ZhiliangMa/202004-F103-IOT-DEV_V1/(threads)

Thread 1 (2020-10-10):

作者你好，我下载了你分享的这个程序。内容完全不是你所说的呀。除了 OLED ，UART1 外都不能运行呀！

OPYS2, 2020-10-10:
你好 ，为了验证我买的W5500模块是否正常，下载了这个程序 。发现除了 SPI1 端口接的 OLED屏，和 UART1 串口可以运行外 ，UART2 UART3  SPI2（W5500）根本无法运行，你的程序都不全呀。不全你也不标示一下 ，有需要的人 下来使用 ，又要浪费多少时间，排查 ，除错。特别是STM32的 程序都是交叉库的形式调用，组合在一起的 。而且是生手，不知道你的编写思路，流程的人，是真的痛苦。
如果你是达成这个功能目标，请在说明文档内，说一下，哪些不完整 需要完善 ，那些有缺陷 需要修正。相互学习提升能力，才是目的。
  谢谢你的 分享。

ZhiliangMa, 2020-10-10:
W5500确实没有完善程序，博客里面有说。硬件是支持的。由于时间有限，主要还是用的ESP8266。W5500的程序估计不会更新了，应用太局限了，不想花太多时间在这单一硬件上面。如果有需要，你可以找找超纬电子的资料，esp8266联网部分我是参照他的，W5500实在没空抱歉，可以参照他的进行开发。

------------------&nbsp;原始邮件&nbsp;------------------
发件人:                                                                                                                        "ZhiliangMa/202004-F103-IOT-DEV_V1"                                                                                    <notifications@github.com&gt;;
发送时间:&nbsp;2020年10月10日(星期六) 中午12:53
收件人:&nbsp;"ZhiliangMa/202004-F103-IOT-DEV_V1"<202004-F103-IOT-DEV_V1@noreply.github.com&gt;;
抄送:&nbsp;"Subscribed"<subscribed@noreply.github.com&gt;;
主题:&nbsp;[ZhiliangMa/202004-F103-IOT-DEV_V1] 作者你好，我下载了你分享的这个程序。内容完全不是你所说的呀。除了 OLED ，UART1 外都不能运行呀！ (#1)

你好 ，为了验证我买的W5500模块是否正常，下载了这个程序 。发现除了 SPI1 端口接的 OLED屏，和 UART1 串口可以运行外 ，UART2 UART3  SPI2（W5500）根本无法运行，你的程序都不全呀。不全你也不标示一下 ，有需要的人 下来使用 ，又要浪费多少时间，排查 ，除错。特别是STM32的 程序都是交叉库的形式调用，组合在一起的 。而且是生手，不知道你的编写思路，流程的人，是真的痛苦。
 如果你是达成这个功能目标，请在说明文档内，说一下，哪些不完整 需要完善 ，那些有缺陷 需要修正。相互学习提升能力，才是目的。
 谢谢你的 分享。

—
You are receiving this because you are subscribed to this thread.
Reply to this email directly, view it on GitHub, or unsubscribe.
