ZhiliangMa/202004-F103-IOT-DEV_V1/F103-IOT-IC.pdf

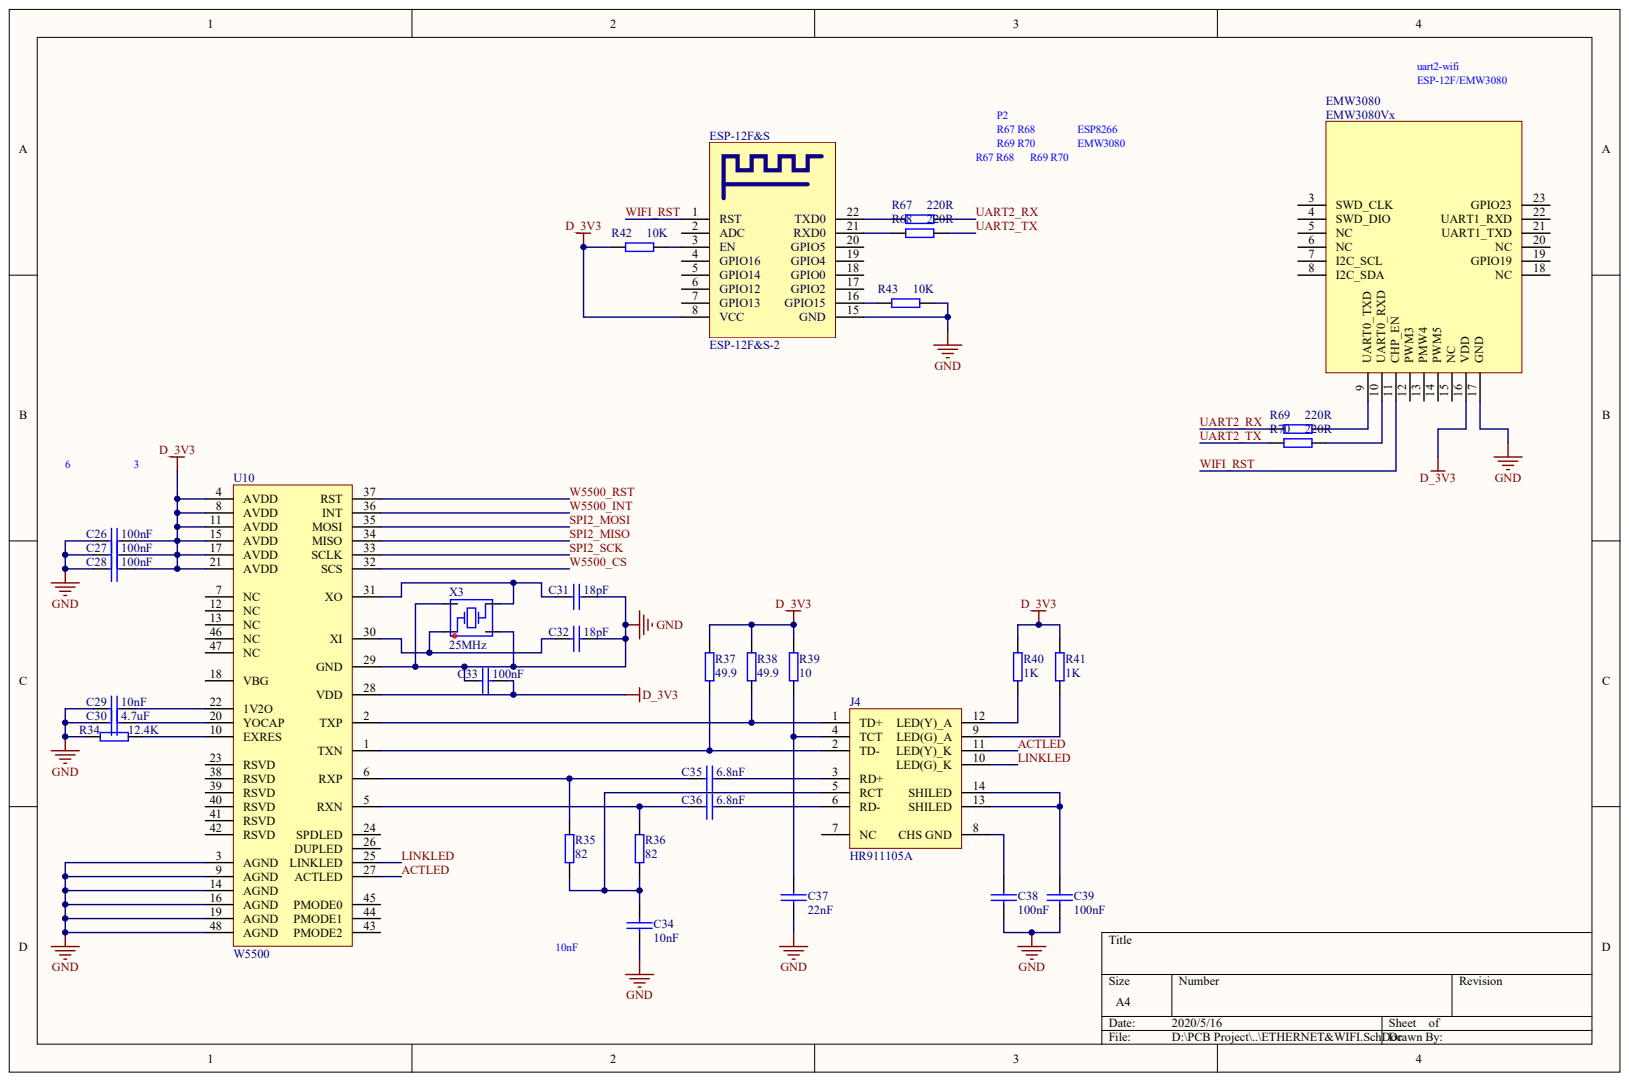
[picture p3: page 1]

C27 | 100nF | AVDD 17
C28 | 100nF | AVDD 21

EXRES 10 | TCT 4

AGND 9
AGND 14
AGND 16
AGND 19
AGND 48

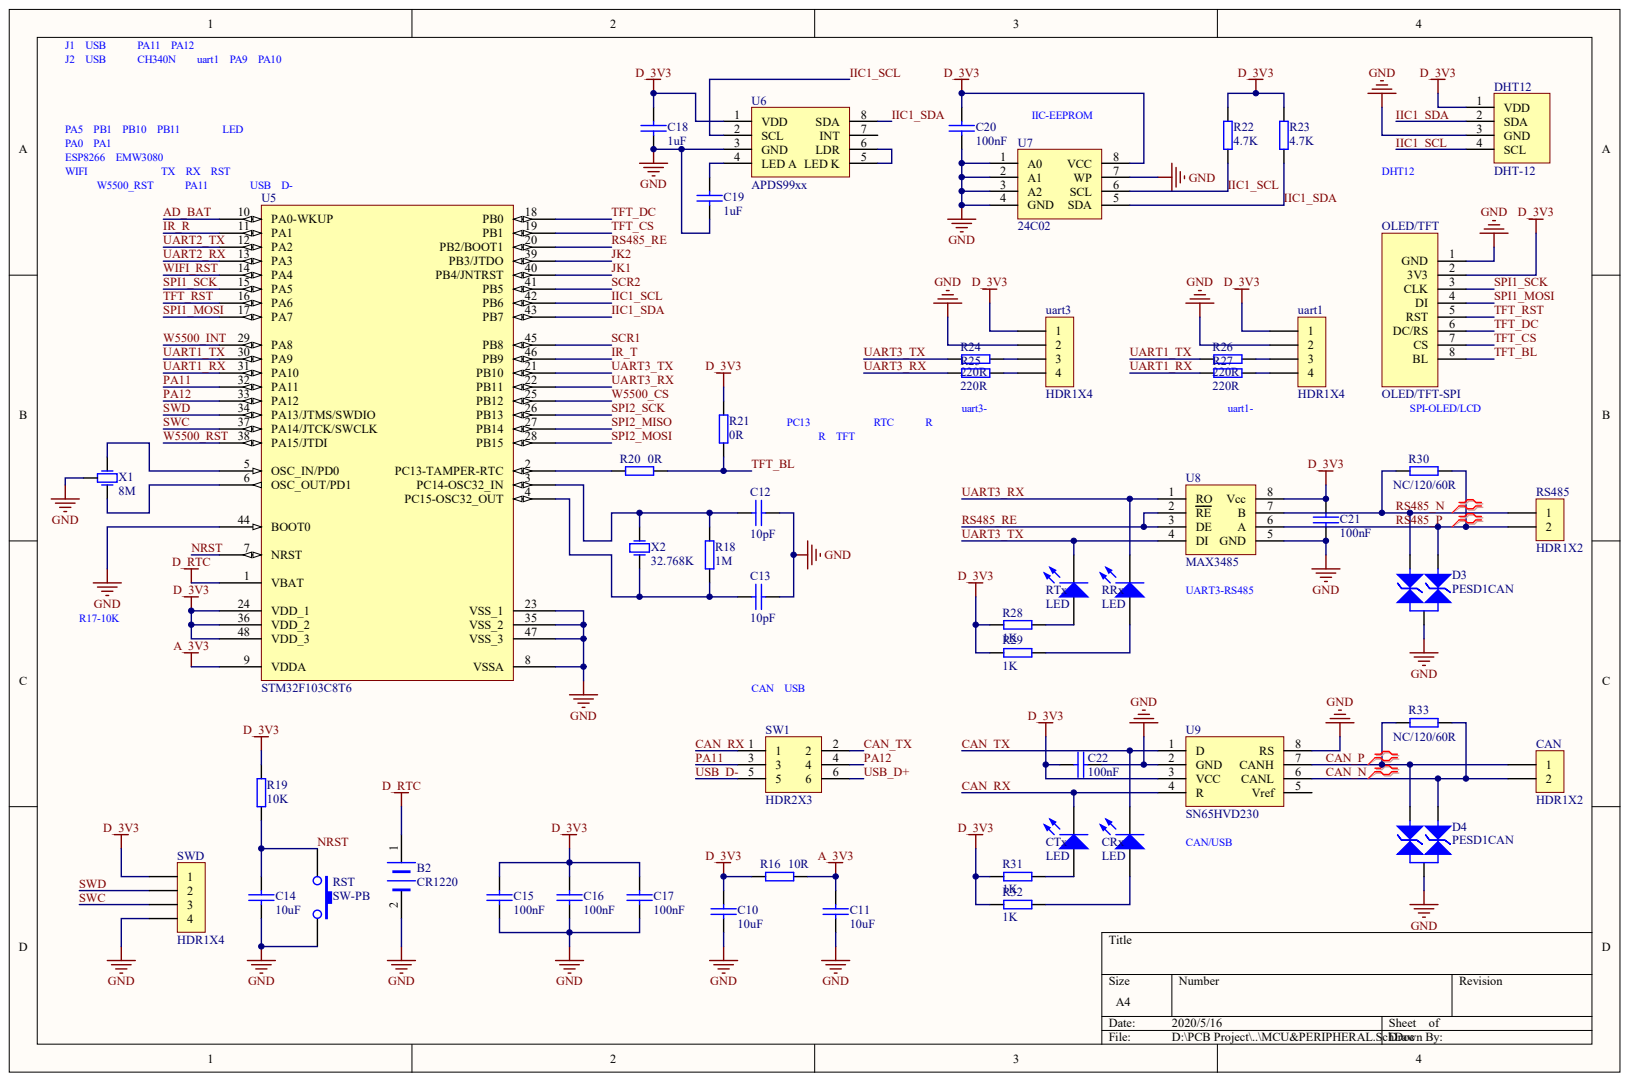
[picture p4: page 2]

X1 | OSC_OUT/PD1 6

OSC_IN/PD0 5

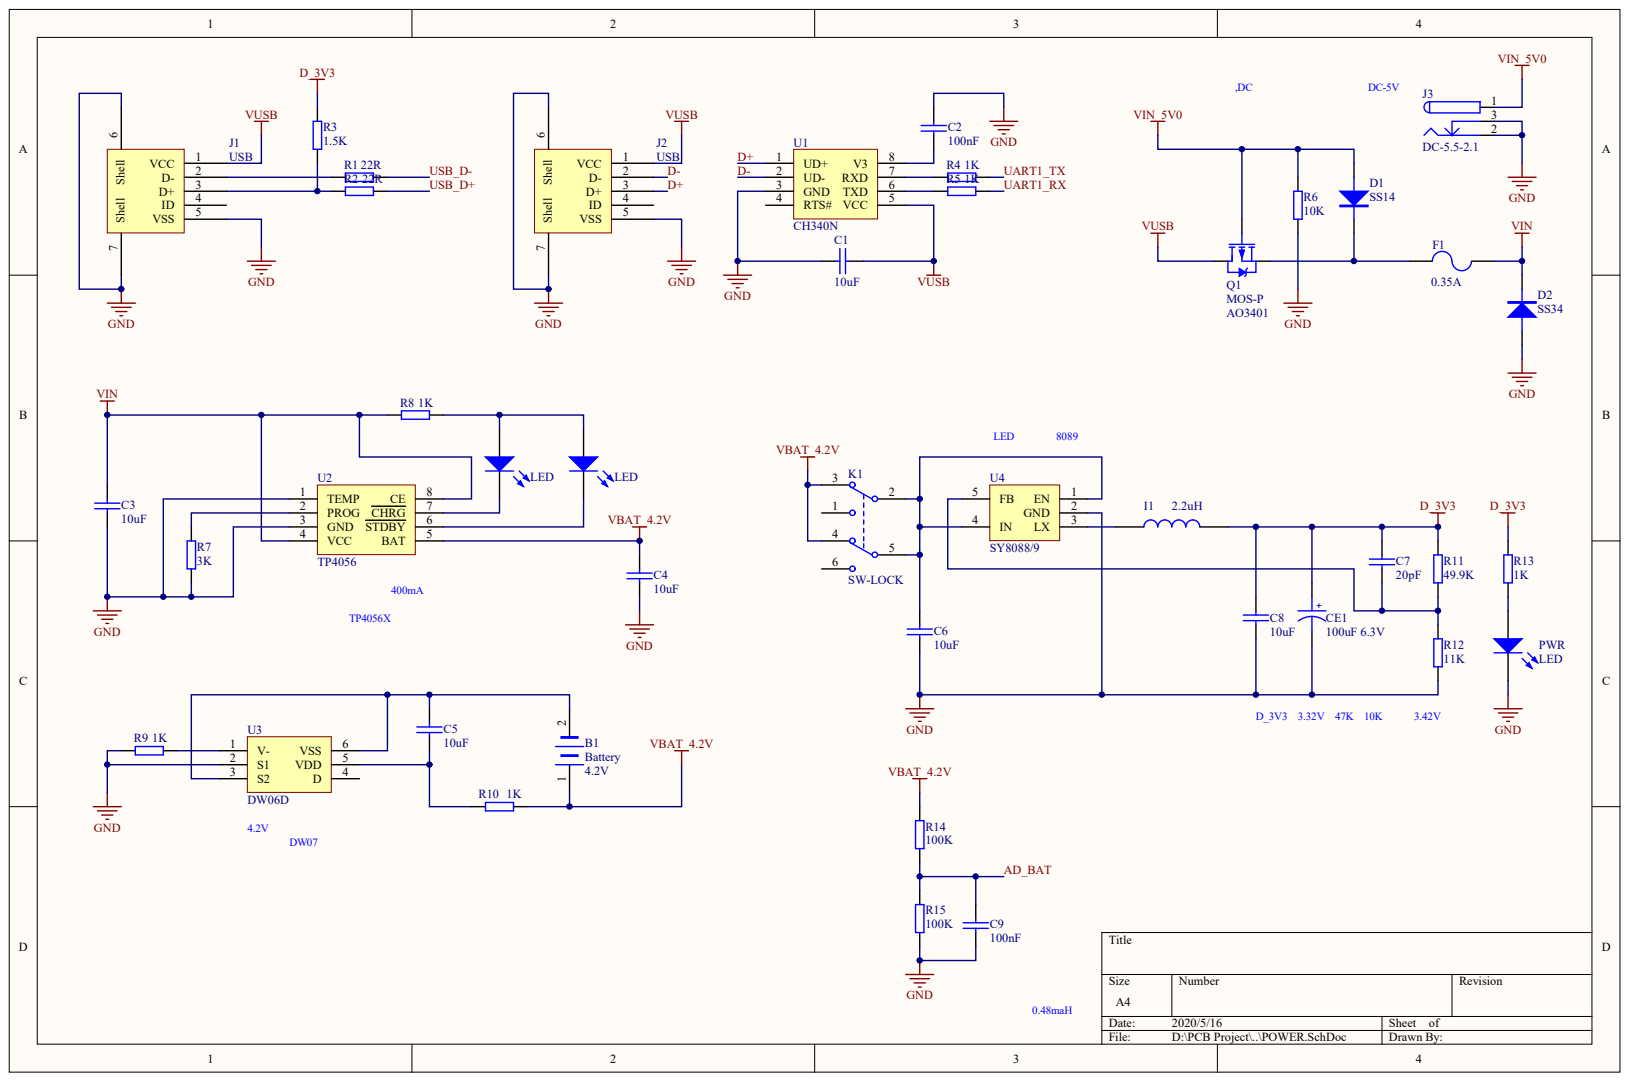
[picture p5: page 3]

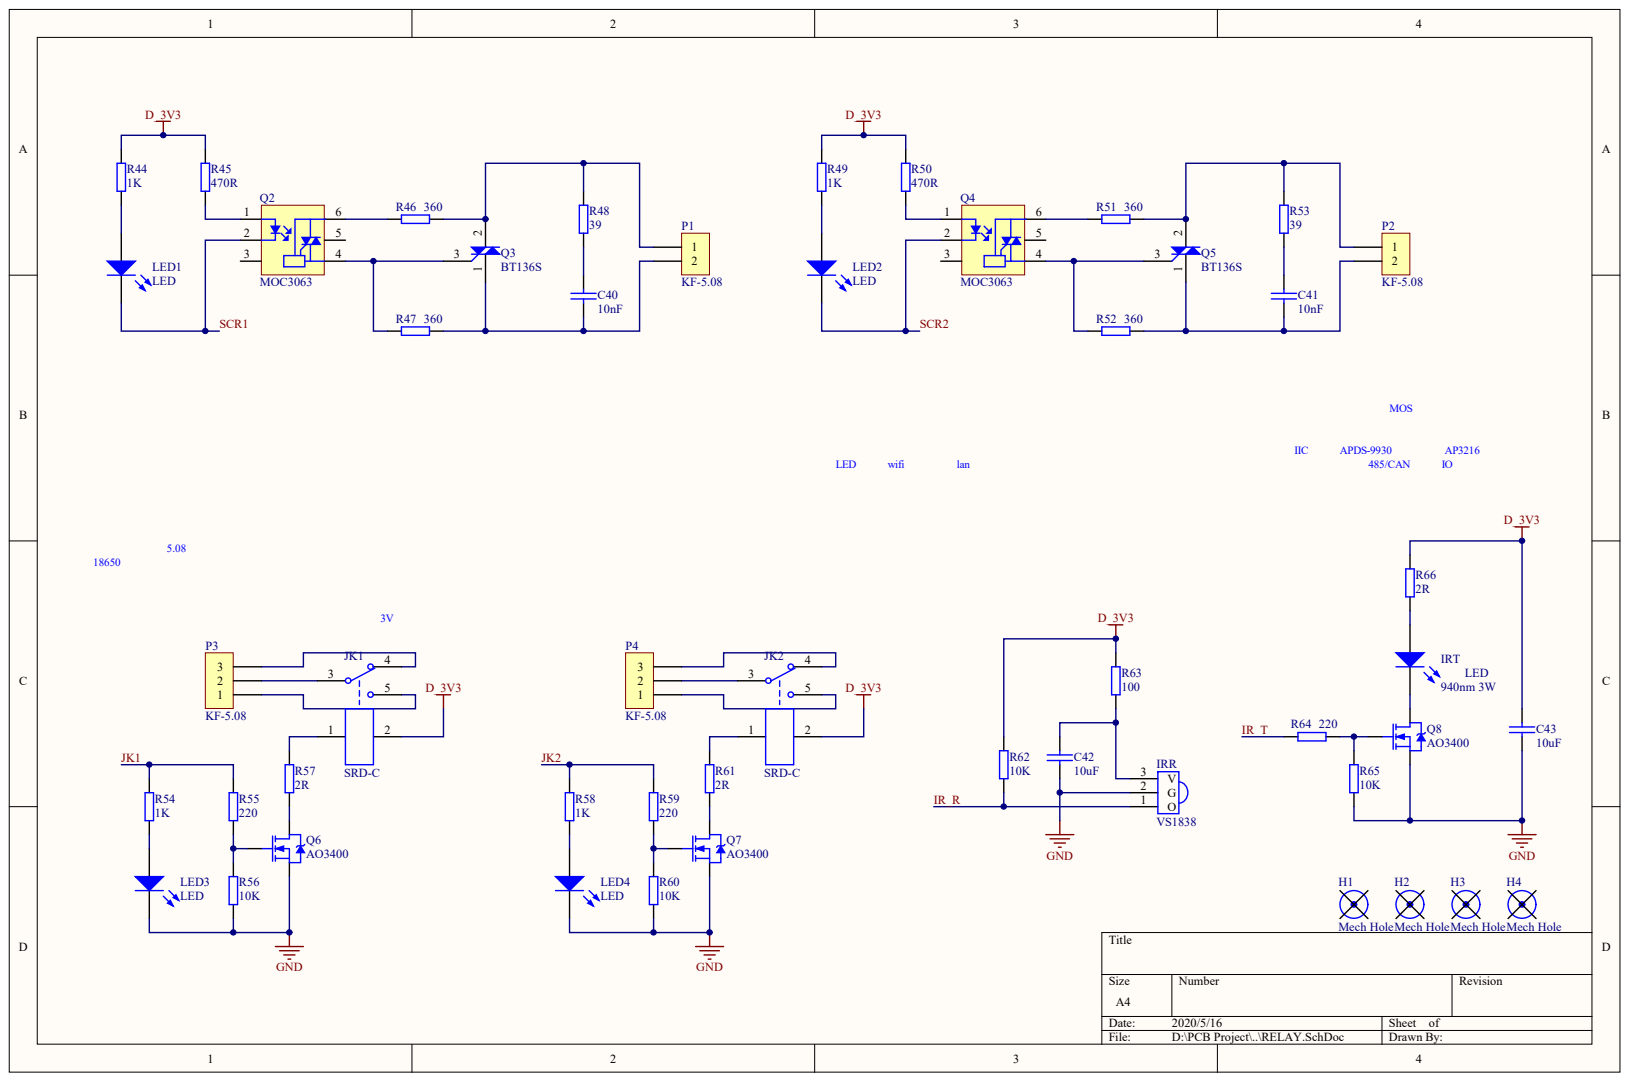
[picture p6: page 4]

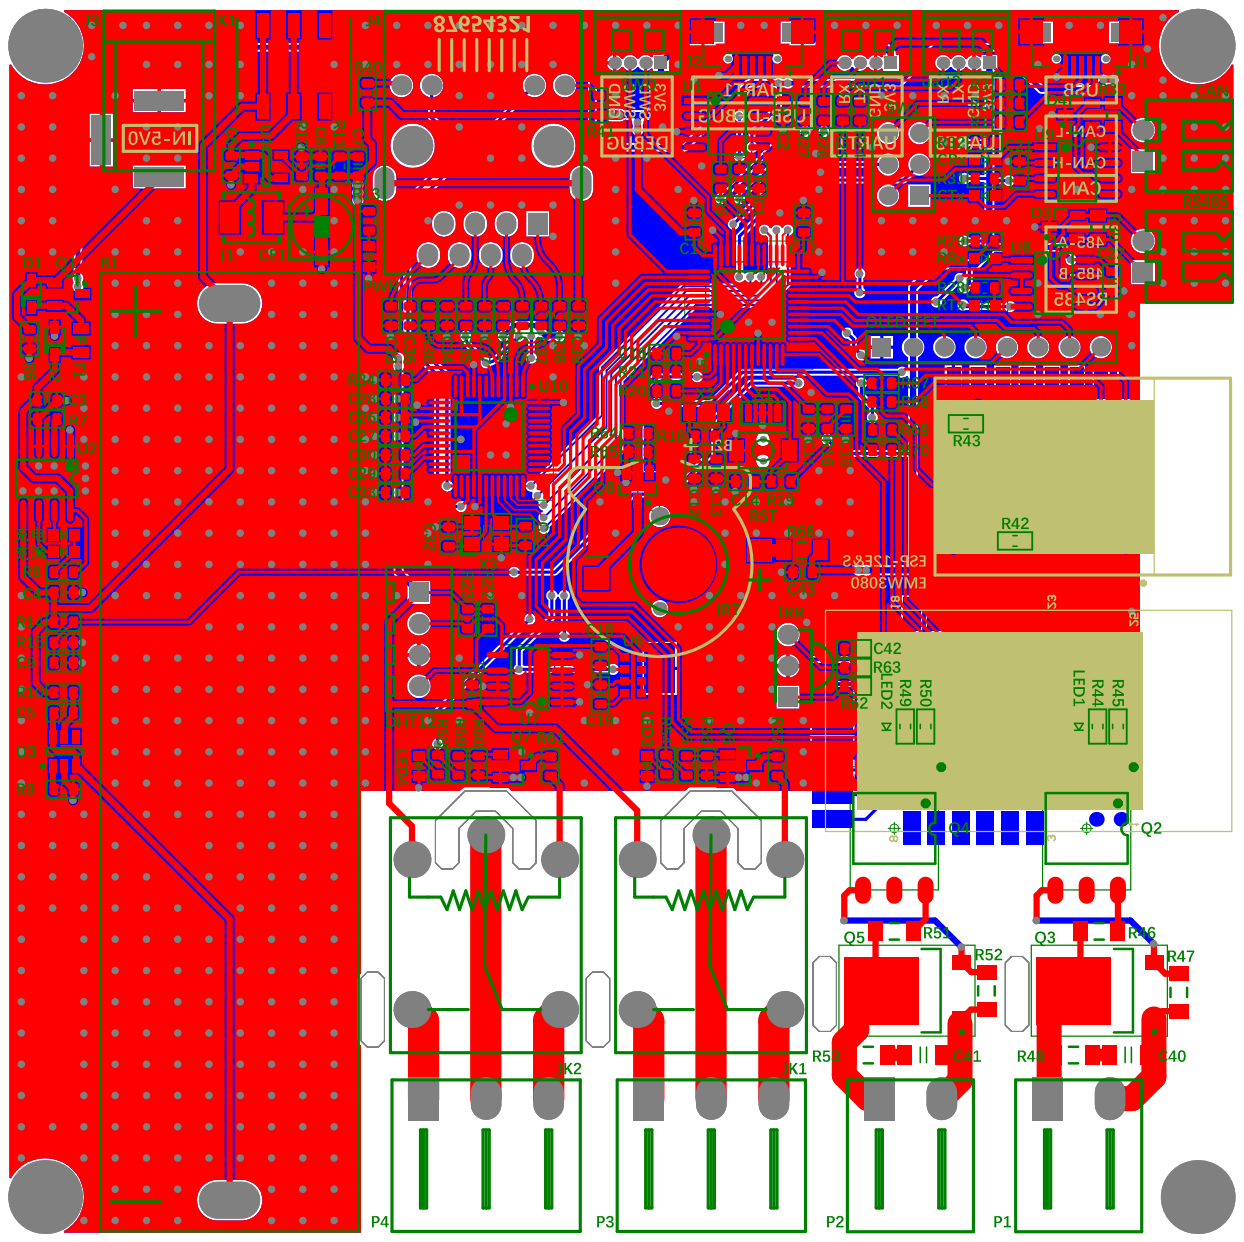
[picture p7: page 5]
