ZhiliangMa/202004-F103-IOT-DEV_V1/peripheral/oled1/oled1.c

#include "oled.h"

u8 Interface ;

#define XLevelL		0x00
#define XLevelH		0x10
#define XLevel		((XLevelH&0x0F)*16+XLevelL)
#define Max_Column	128
#define Max_Row		  64
#define	Brightness	0xCF 

#define X_WIDTH 128
#define Y_WIDTH 64

//OLED显存   
//u8 OLED_GRAM[128][8];	

const u8 F6x8[][6] =
{0/*
    { 0x00, 0x00, 0x00, 0x00, 0x00, 0x00 },   // sp
    { 0x00, 0x00, 0x00, 0x2f, 0x00, 0x00 },   // !
    { 0x00, 0x00, 0x07, 0x00, 0x07, 0x00 },   // "
    { 0x00, 0x14, 0x7f, 0x14, 0x7f, 0x14 },   // #
    { 0x00, 0x24, 0x2a, 0x7f, 0x2a, 0x12 },   // $
    { 0x00, 0x62, 0x64, 0x08, 0x13, 0x23 },   // %
    { 0x00, 0x36, 0x49, 0x55, 0x22, 0x50 },   // &
    { 0x00, 0x00, 0x05, 0x03, 0x00, 0x00 },   // '
    { 0x00, 0x00, 0x1c, 0x22, 0x41, 0x00 },   // (
    { 0x00, 0x00, 0x41, 0x22, 0x1c, 0x00 },   // )
    { 0x00, 0x14, 0x08, 0x3E, 0x08, 0x14 },   // *
    { 0x00, 0x08, 0x08, 0x3E, 0x08, 0x08 },   // +
    { 0x00, 0x00, 0x00, 0xA0, 0x60, 0x00 },   // ,
    { 0x08, 0x08, 0x08, 0x08, 0x08, 0x08 },   // -
    { 0x00, 0x00, 0x60, 0x60, 0x00, 0x00 },   // .
    { 0x00, 0x20, 0x10, 0x08, 0x04, 0x02 },   // /
    { 0x00, 0x3E, 0x51, 0x49, 0x45, 0x3E },   // 0
    { 0x00, 0x00, 0x42, 0x7F, 0x40, 0x00 },   // 1
    { 0x00, 0x42, 0x61, 0x51, 0x49, 0x46 },   // 2
    { 0x00, 0x21, 0x41, 0x45, 0x4B, 0x31 },   // 3
    { 0x00, 0x18, 0x14, 0x12, 0x7F, 0x10 },   // 4
    { 0x00, 0x27, 0x45, 0x45, 0x45, 0x39 },   // 5
    { 0x00, 0x3C, 0x4A, 0x49, 0x49, 0x30 },   // 6
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
  0x00,0x00,0x00,0x80,0x00,0x00,0x00,0x00,0x00,0x00,0x80,0x60,0x00,0x00,0x00,0x00,//;27
  0x00,0x00,0x80,0x40,0x20,0x10,0x08,0x00,0x00,0x01,0x02,0x04,0x08,0x10,0x20,0x00,//<28
  0x40,0x40,0x40,0x40,0x40,0x40,0x40,0x00,0x04,0x04,0x04,0x04,0x04,0x04,0x04,0x00,//=29
  0x00,0x08,0x10,0x20,0x40,0x80,0x00,0x00,0x00,0x20,0x10,0x08,0x04,0x02,0x01,0x00,//>30
  0x00,0x70,0x48,0x08,0x08,0x08,0xF0,0x00,0x00,0x00,0x00,0x30,0x36,0x01,0x00,0x00,//?31
  0xC0,0x30,0xC8,0x28,0xE8,0x10,0xE0,0x00,0x07,0x18,0x27,0x24,0x23,0x14,0x0B,0x00,//@32
  0x00,0x00,0xC0,0x38,0xE0,0x00,0x00,0x00,0x20,0x3C,0x23,0x02,0x02,0x27,0x38,0x20,//A33
  0x08,0xF8,0x88,0x88,0x88,0x70,0x00,0x00,0x20,0x3F,0x20,0x20,0x20,0x11,0x0E,0x00,//B34
  0xC0,0x30,0x08,0x08,0x08,0x08,0x38,0x00,0x07,0x18,0x20,0x20,0x20,0x10,0x08,0x00,//C35
  0x08,0xF8,0x08,0x08,0x08,0x10,0xE0,0x00,0x20,0x3F,0x20,0x20,0x20,0x10,0x0F,0x00,//D36
  0x08,0xF8,0x88,0x88,0xE8,0x08,0x10,0x00,0x20,0x3F,0x20,0x20,0x23,0x20,0x18,0x00,//E37
  0x08,0xF8,0x88,0x88,0xE8,0x08,0x10,0x00,0x20,0x3F,0x20,0x00,0x03,0x00,0x00,0x00,//F38
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
*/
};
	 
const u8 LOGO128x64[1024] = {0,}; 

/**************************实现函数********************************************
*函数原型:    void OLED_WR_Byte(uint8_t dat,uint8_t cmd)
*功　　能:    OLED写入数据/命令
输入参数：    dat  要输入的数据
              cmd  1:命令  0：数据
输出参数：    无
*******************************************************************************/
void OLED_WR_Byte(uint8_t dat,uint8_t cmd)
{	
	 u8 i;
	(cmd>0)?(OLED_DC_H()):(OLED_DC_L());

	#ifdef HardWare_SPI
		SPI1_ReadWriteByte(dat);
	  OLED_DC_H();  
	#endif
	
	#ifdef SoftWare_SPI
 	  if(cmd)   OLED_DC_H();
    else      OLED_DC_L();		  
    for(i=0;i<8;i++)
    {			  
	    OLED_D0_L();
	    if(dat&0x80)   OLED_D1_H();
	    else           OLED_D1_L();
	    OLED_D0_H();
	    dat<<=1;   
    }
		OLED_DC_H();  
	#endif
		
	#ifdef SoftWare_IIC 
		//iic code... 
	#endif		
}  

void OLED_DLY_ms(u16 ms)
{                         
  u16 a;
  while(ms)
  {
    a=1335;
    while(a--);
    ms--;
  }
  return;
}

//初始化SSD1306	
void OLED_Init(void)        
{
  GPIO_InitTypeDef OLED_GPIO_InitStructure;
	RCC_APB2PeriphClockCmd(RCC_APB2Periph_GPIOA|RCC_APB2Periph_GPIOB|RCC_APB2Periph_GPIOC, ENABLE); 
	
  OLED_GPIO_InitStructure.GPIO_Pin = OLED_RST|OLED_DC;
	OLED_GPIO_InitStructure.GPIO_Speed = GPIO_Speed_50MHz;
	OLED_GPIO_InitStructure.GPIO_Mode = GPIO_Mode_Out_PP;
	GPIO_Init(GPIOB, &OLED_GPIO_InitStructure); 

	#ifdef SoftWare_SPI
		OLED_GPIO_InitStructure.GPIO_Pin = OLED_D0|OLED_D1;
		OLED_GPIO_InitStructure.GPIO_Speed = GPIO_Speed_50MHz;
		OLED_GPIO_InitStructure.GPIO_Mode = GPIO_Mode_Out_PP;
		GPIO_Init(GPIOA, &OLED_GPIO_InitStructure);
	#endif      
	
	#ifdef HardWare_SPI
		SPI1_Init();
	#endif
	
  OLED_GPIO_InitStructure.GPIO_Pin = OLED_CS;
	OLED_GPIO_InitStructure.GPIO_Speed = GPIO_Speed_50MHz;
	OLED_GPIO_InitStructure.GPIO_Mode = GPIO_Mode_Out_PP;
	GPIO_Init(GPIOC, &OLED_GPIO_InitStructure); 		
	
	GPIO_ResetBits(GPIOC,OLED_CS);

	#ifdef GPIO_DEBUG
		while(1)
		{
			
			OLED_RST_H();OLED_D0_H();OLED_D1_H();OLED_DC_H();OLED_CS_H();delay_ms(1500);
			OLED_RST_L();OLED_D0_L();OLED_D1_L();OLED_DC_L();OLED_CS_L();delay_ms(1500);	
		}
	#endif
	
	OLED_D0_H();  	
	OLED_RST_L();
  OLED_DLY_ms(50); //reset 引脚复位
  OLED_RST_H();
	
  OLED_WR_Byte(0xAE,OLED_CMD); //关闭显示
	OLED_WR_Byte(0xD5,OLED_CMD); //设置时钟分频因子,震荡频率
	OLED_WR_Byte(0X80,OLED_CMD); //[3:0],分频因子;[7:4],震荡频率
	OLED_WR_Byte(0xA8,OLED_CMD); //设置驱动路数
	OLED_WR_Byte(0X3F,OLED_CMD); //默认0X3F(1/64) 
	OLED_WR_Byte(0xD3,OLED_CMD); //设置显示偏移
	OLED_WR_Byte(0X00,OLED_CMD); //默认为0
	OLED_WR_Byte(0x40|0X00,OLED_CMD); //设置显示开始行 [5:0],行数.													    
	OLED_WR_Byte(0x8D,OLED_CMD); //电荷泵设置
	OLED_WR_Byte(0x14,OLED_CMD); //bit2，开启/关闭
	OLED_WR_Byte(0x20,OLED_CMD); //设置内存地址模式
	OLED_WR_Byte(0x02,OLED_CMD); //[1:0],00，列地址模式;01，行地址模式;10,页地址模式;默认10;
	OLED_WR_Byte(0xA1,OLED_CMD); //段重定义设置,bit0:0,0->0;1,0->127;
	OLED_WR_Byte(0xC8,OLED_CMD); //设置COM扫描方向;bit3:0,普通模式;1,重定义模式 COM[N-1]->COM0;N:驱动路数
	OLED_WR_Byte(0xDA,OLED_CMD); //设置COM硬件引脚配置
	OLED_WR_Byte(0x12,OLED_CMD); //[5:4]配置		 
	OLED_WR_Byte(0x81,OLED_CMD); //对比度设置
	OLED_WR_Byte(0xEF,OLED_CMD); //1~255;默认0X7F (亮度设置,越大越亮)
	OLED_WR_Byte(0xD9,OLED_CMD); //设置预充电周期
	OLED_WR_Byte(0xf1,OLED_CMD); //[3:0],PHASE 1;[7:4],PHASE 2;
	OLED_WR_Byte(0xDB,OLED_CMD); //设置VCOMH 电压倍率
	OLED_WR_Byte(0x40,OLED_CMD); //[6:4] 000,0.65*vcc;001,0.77*vcc;011,0.83*vcc;
	OLED_WR_Byte(0xA4,OLED_CMD); //全局显示开启;bit0:1,开启;0,关闭;(白屏/黑屏)
	OLED_WR_Byte(0xA6,OLED_CMD); //设置显示方式;bit0:1,反相显示;0,正常显示	    						   
	OLED_WR_Byte(0xAF,OLED_CMD); //开启显示	 

  OLED_Fill(0x00);  //初始清屏
} 

//************************************** 底层驱动代码 ******************************************************
void OLED_WrDat(u8 dat) 
{
	u8 i=8;   //SSD1306 datasheet （4-wire SPI） pdf--18

	#ifdef HardWare_SPI
		OLED_DC_H(); __NOP(); //写数据
		OLED_D0_L(); __NOP(); //时钟起始低电平
		SPI1_ReadWriteByte(dat);
	#endif	

	#ifdef SoftWare_SPI
		OLED_DC_H(); __NOP(); //写数据
		OLED_D0_L(); __NOP(); //时钟起始低电平
		while(i--) //D7 D6 ... D0,上升沿写入
		{
			if(data&0x80) OLED_D1_H();
			else					OLED_D1_L();
			
			OLED_D0_H();  
			__NOP();      
			OLED_D0_L();  
			
			data <<= 1;      
		}
	#endif
		
	#ifdef SoftWare_IIC 
		//iic code... 
	#endif		  
}

void OLED_WrCmd(u8 cmd) //同上一个时序图
{
	u8 i=8;   //SSD1306 datasheet （4-wire SPI） pdf--18

	#ifdef HardWare_SPI
		 OLED_DC_L();  __NOP(); //写命令
		 OLED_D0_L();  __NOP(); //时钟起始低电平
		 SPI1_ReadWriteByte(cmd);
	#endif	

	#ifdef SoftWare_SPI
	  OLED_DC_L();  __NOP(); //写命令
		OLED_D0_L();  __NOP(); //时钟起始低电平
		 while(i--)
		 {
				if(cmd&0x80) OLED_D1_H();
				else				 OLED_D1_L();
				
				OLED_D0_H();  
				__NOP();      
				OLED_D0_L();  				 
				cmd <<= 1;
		} 	
	#endif
		
	#ifdef SoftWare_IIC 
		//iic code... 
	#endif	
}

void OLED_Set_Pos(u8 x, u8 y)
{ 
	//哪一页显示（0~7）
  OLED_WrCmd(0xb0+y);             //SSD1306 datasheet  pdf--31   1011_0 x x x(0~7)

	//哪一页的哪一竖行开始显示（0~127）
	OLED_WrCmd(((x&0xf0)>>4)|0x10); //SSD1306 datasheet  pdf--30   0001_x x x x
  OLED_WrCmd((x&0x0f)|0x00);       //SSD1306 datasheet  pdf--30   0000_x x x x
} 

void OLED_Fill(u8 bmp_data) //写数据比如写0x00为清屏, 0xFF为满屏
{
	u8 y,x;
	
	for(y=0;y<8;y++)
	{
		OLED_WrCmd(0xb0+y); //含义：从每一页 的 每一竖行首 开始写（循环128次）0
		OLED_WrCmd(0x01);
		OLED_WrCmd(0x10);
		
		for(x=0;x<X_WIDTH;x++)
			OLED_WrDat(bmp_data);
	}
}

void OLED_CLS(void) //清屏，向DDRAM内写入0即实现
{
	u8 y,x;	
	for(y=0;y<8;y++)
	{
		OLED_WrCmd(0xb0+y); //含义：从每一页 的 每一竖行首 开始写（循环128次）0
		OLED_WrCmd(0x01);
		OLED_WrCmd(0x10); 
		
		for(x=0;x<X_WIDTH;x++)
			OLED_WrDat(0);
	}
}

//自定义 -- 反白一行
u8 Menu1[]={0x20,0x40,0x80,0x40,0x20,0x10,0x08,0x04};//对勾号
u8 Menu2[]={0x00,0x18,0x28,0x4E,0x4E,0x48,0x18,0x00};//LED号
void OLED_WhiteLine(u8 line , u8 num) //line:0~7
{
  u8 x,*p;
	//static u8 last;
	
	if(num == 1) p = Menu1;	
	if(num == 2) p= Menu2;
	if(num == 0) //if(last != line)  
	{
		OLED_WrCmd(0xb0+line);//0xb0+(line+1);  0xb0+last;
		OLED_WrCmd(0x08);     //设置列地址低四位0x01  y~128
		OLED_WrCmd(0x17);     //设置列地址高四位0x10 
		for(x=120;x<X_WIDTH;x++)//128列*64行
			OLED_WrDat(0x00); 
	}
	else
	{
		OLED_WrCmd(0xb0+line);  //OLED_WrCmd(0xb0+(line+1));
		OLED_WrCmd(0x08);       //设置列地址低四位0x01  y~128
		OLED_WrCmd(0x17);       //设置列地址高四位0x10 
		for(x=120;x<X_WIDTH;x++)//128列*64行
			OLED_WrDat(*p++);  //OLED_WrDat(0xFF); 
	}
	//last=line;		
}
void OLED_ClrLine(u8 line)
{
	u8 x;	
	OLED_WrCmd(0xb0+line);
	OLED_WrCmd(0x01);
	OLED_WrCmd(0x10); 
	for(x=0;x<X_WIDTH;x++)
    OLED_WrDat(0);
}
//************************************** 底层代码完 ******************************************************

//
void Set_Display_Offset(u8 d)
{
	OLED_WrCmd(0xD3);			// Set Display Offset
	OLED_WrCmd(d);			//   Default => 0x00
}

void adjust(u8 a)
{
  OLED_WrCmd(a);	//指令数据0x0000~0x003f  
}

void SetStartColumn(u8 d)
{
	OLED_WrCmd(0x00+d%16);		// Set Lower Column Start Address for Page Addressing Mode
						//   Default => 0x00
	OLED_WrCmd(0x10+d/16);		// Set Higher Column Start Address for Page Addressing Mode
						//   Default => 0x10
}

void SetAddressingMode(u8 d)	
{
	OLED_WrCmd(0x20);			// Set Memory Addressing Mode
	OLED_WrCmd(d);			//   Default => 0x02
						//     0x00 => Horizontal Addressing Mode
						//     0x01 => Vertical Addressing Mode
						//     0x02 => Page Addressing Mode
}

void SetColumnAddress(u8 a, u8 b)
{
	OLED_WrCmd(0x21);			// Set Column Address
	OLED_WrCmd(a);			//   Default => 0x00 (Column Start Address)
	OLED_WrCmd(b);			//   Default => 0x7F (Column End Address)
}

void SetPageAddress(u8 a, u8 b)
{
	OLED_WrCmd(0x22);			// Set Page Address
	OLED_WrCmd(a);			//   Default => 0x00 (Page Start Address)
	OLED_WrCmd(b);			//   Default => 0x07 (Page End Address)
}

  void SetStartLine(u8 d)
{
	OLED_WrCmd(0x40|d);			// Set Display Start Line
						//   Default => 0x40 (0x00)
}

//设置对比度,值设置得越大屏幕就越亮(1~255)
void OLED_BkgLight(u8 d)
{
	OLED_WrCmd(0x81);			// Set Contrast Control
	OLED_WrCmd(d);			  // Default => 0x7F = 127(10)
}

void Set_Charge_Pump(u8 d)
{
	OLED_WrCmd(0x8D);			// Set Charge Pump
	OLED_WrCmd(0x10|d);			//   Default => 0x10
						//     0x10 (0x00) => Disable Charge Pump
						//     0x14 (0x04) => Enable Charge Pump
}

void Set_Segment_Remap(u8 d)
{
	OLED_WrCmd(0xA0|d);			// Set Segment Re-Map
						//   Default => 0xA0
						//     0xA0 (0x00) => Column Address 0 Mapped to SEG0
						//     0xA1 (0x01) => Column Address 0 Mapped to SEG127
}

void Set_Entire_Display(u8 d)
{
	OLED_WrCmd(0xA4|d);			// Set Entire Display On / Off
						//   Default => 0xA4
						//     0xA4 (0x00) => Normal Display
						//     0xA5 (0x01) => Entire Display On
}

void Set_Inverse_Display(u8 d)
{
	OLED_WrCmd(0xA6|d);			// Set Inverse Display On/Off
						//   Default => 0xA6
						//     0xA6 (0x00) => Normal Display
						//     0xA7 (0x01) => Inverse Display On
}

void Set_Multiplex_Ratio(u8 d)
{
	OLED_WrCmd(0xA8);			// Set Multiplex Ratio
	OLED_WrCmd(d);			//   Default => 0x3F (1/64 Duty)
}

//全局显示开启; bit0:1,开启;0,关闭;(白屏/黑屏)
void OLED_DisOnOff(u8 d)
{
	//Default => 0xAE
	//0xAE (0x00) => Display Off
	//0xAF (0x01) => Display On
	OLED_WrCmd(0xAE|d);			// Set Display On/Off 
}

void SetStartPage(u8 d)
{
	OLED_WrCmd(0xB0|d);			// Set Page Start Address for Page Addressing Mode
						//   Default => 0xB0 (0x00)
}

void Set_Common_Remap(u8 d)
{
	OLED_WrCmd(0xC0|d);			// Set COM Output Scan Direction
						//   Default => 0xC0
						//     0xC0 (0x00) => Scan from COM0 to 63
						//     0xC8 (0x08) => Scan from COM63 to 0
}



void Set_Display_Clock(u8 d)
{
	OLED_WrCmd(0xD5);			// Set Display Clock Divide Ratio / Oscillator Frequency
	OLED_WrCmd(d);			//   Default => 0x80
						//     D[3:0] => Display Clock Divider
						//     D[7:4] => Oscillator Frequency
}

void Set_Precharge_Period(u8 d)
{
	OLED_WrCmd(0xD9);			// Set Pre-Charge Period
	OLED_WrCmd(d);			//   Default => 0x22 (2 Display Clocks [Phase 2] / 2 Display Clocks [Phase 1])
						//     D[3:0] => Phase 1 Period in 1~15 Display Clocks
						//     D[7:4] => Phase 2 Period in 1~15 Display Clocks
}

void Set_Common_Config(u8 d)
{
	OLED_WrCmd(0xDA);			// Set COM Pins Hardware Configuration
	OLED_WrCmd(0x02|d);			//   Default => 0x12 (0x10)
						//     Alternative COM Pin Configuration
						//     Disable COM Left/Right Re-Map
}

void Set_VCOMH(u8 d)
{
	OLED_WrCmd(0xDB);			// Set VCOMH Deselect Level
	OLED_WrCmd(d);			//   Default => 0x20 (0.77*VCC)
}

void Set_NOP(void)
{
	OLED_WrCmd(0xE3);			// Command for No Operation
}
 
//==============================================================
//函数名：LCD_P6x8Str(u8 x,u8 y,u8 *p)
//功能描述：写入一组标准ASCII字符串
//参数：显示的位置（x,y），y为页范围0～7，要显示的字符串
//返回：无
//==============================================================  
void OLED_P6x8Str(u8 x,u8 y,u8 ch[])//小字符串
{
  u8 c=0,i=0,j=0;

  OLED_Set_Pos(x,y);      
  while (ch[j]!='\0')
  {    
    c =ch[j]-32;
    if(x>126){x=0;y++;}    
  	for(i=0;i<6;i++)     
  	  OLED_WrDat(F6x8[c][i]);  
  	x+=6;
  	j++;
  } 
}
//==============================================================
//函数名：LCD_P8x16Str(u8 x,u8 y,u8 *p)
//功能描述：写入一组标准ASCII字符串
//参数：显示的位置（x,y），y为页范围0～7，要显示的字符串
//返回：无
//==============================================================  
void OLED_P8x16Str(u8 x,u8 y,u8 ch[])//大字符串
{
  u8 c=0,i=0,j=0;
        
  while (ch[j]!='\0')
  {    
    c =ch[j]-32;
    if(x>120){x=0;y++;}
    OLED_Set_Pos(x,y);    
  	for(i=0;i<8;i++)     
  	  OLED_WrDat(F8X16[c*16+i]);
  	OLED_Set_Pos(x,y+1);    
  	for(i=0;i<8;i++)     
  	  OLED_WrDat(F8X16[c*16+i+8]);  
  	x+=8;
  	j++;
  }
}
//输出汉字字符串
void OLED_P14x16Str(u8 x,u8 y,u8 ch[])
{
//	u8 wm=0,ii = 0;
//	u16 adder=1; 
//	
//	while(ch[ii] != '\0')
//	{
//  	wm = 0;
//  	adder = 1;
//  	while(F14x16_Idx[wm] > 127)
//  	{
//  		if(F14x16_Idx[wm] == ch[ii])
//  		{
//  			if(F14x16_Idx[wm + 1] == ch[ii + 1])
//  			{
//  				adder = wm * 14;
//  				break;
//  			}
//  		}
//  		wm += 2;			
//  	}
//  	if(x>118){x=0;y++;}
//  	OLED_Set_Pos(x , y); 
//  	if(adder != 1)// 显示汉字					
//  	{
//  		OLED_Set_Pos(x , y);
//  		for(wm = 0;wm < 14;wm++)               
//  		{
//  			OLED_WrDat(F14x16[adder]);	
//  			adder += 1;
//  		}      
//  		OLED_Set_Pos(x,y + 1); 
//  		for(wm = 0;wm < 14;wm++)          
//  		{
//  			OLED_WrDat(F14x16[adder]);
//  			adder += 1;
//  		}   		
//  	}
//  	else			  //显示空白字符			
//  	{
//  		ii += 1;
//      OLED_Set_Pos(x,y);
//  		for(wm = 0;wm < 16;wm++)
//  		{
//  				OLED_WrDat(0);
//  		}
//  		OLED_Set_Pos(x,y + 1);
//  		for(wm = 0;wm < 16;wm++)
//  		{   		
//  				OLED_WrDat(0);	
//  		}
//  	}
//  	x += 14;
//  	ii += 2;
//	}
}
//输出汉字和字符混合字符串
void OLED_Print(u8 x, u8 y, u8 ch[])
{
	u8 ch2[3];
	u8 ii=0;        
	while(ch[ii] != '\0')
	{
		if(ch[ii] > 127)
		{
			ch2[0] = ch[ii];
	 		ch2[1] = ch[ii + 1];
			ch2[2] = '\0';			//汉字为两个字节
			OLED_P14x16Str(x , y, ch2);	//显示汉字
			x += 14;
			ii += 2;
		}
		else
		{
			ch2[0] = ch[ii];	
			ch2[1] = '\0';			//字母占一个字节
			OLED_P8x16Str(x , y , ch2);	//显示字母
			x += 8;
			ii+= 1;
		}
	}
} 

void Dis_Char(u8 y,u8 x,u8 asc) 
{
  u8 ch2[2];
	x=x*8;        
	ch2[0] = asc;	
	ch2[1] = '\0';			//字母占一个字节
	OLED_P6x8Str(x , y , ch2);	//显示字母
}
void Dis_String(u8 y, u8 x, u8 ch[])
{
	u8 ch2[3];
	u8 ii=0;
	x=x*8;        
	while(ch[ii] != '\0')
	{
		if(ch[ii] > 127)
		{
			ch2[0] = ch[ii];
	 		ch2[1] = ch[ii + 1];
			ch2[2] = '\0';			//汉字为两个字节
			OLED_P14x16Str(x , y, ch2);	//显示汉字
			x += 14;
			ii += 2;
		}
		else
		{
			ch2[0] = ch[ii];	
			ch2[1] = '\0';			//字母占一个字节
			OLED_P8x16Str(x , y , ch2);	//显示字母
			x += 8;
			ii+= 1;
		}
	}
}

void Dis_Num(u8 y, u8 x, u16 num,u8 N) 
{
		u8 j=0;
		u8 n[6]={0};
		x=x*8;
		n[0]=(num/10000)%10; 
		n[1]=(num/1000)%10;
		n[2]=(num/100)%10;
		n[3]=(num/10)%10;
		n[4]=num%10;
		//  n[6]='\0';			   
		for(j=0;j<5;j++) n[j]=n[j]+16+32;
		OLED_P8x16Str(x,y,&n[5-N]);//从ACSII码表中读取字节，然后写入液晶
}

void Dis_Float(u8 Y,u8 X,double real,u8 N) 
{
		u8   i_Count=1;
		u8   n[12]={0};
		long   j=1;  
		int    real_int=0;
		double decimal=0;
		u16   real_decimal=0;
		if(real<0)
		{
		  real_int=(int)(-real);
		}
		else
		{
		  real_int=(int)real;
		}
		decimal=real-real_int;
		real_decimal=decimal*1e4;
		while(real_int/10/j!=0)
		{
		  j=j*10;i_Count++;  
		} 
		n[0]=(real_int/10000)%10; 
		n[1]=(real_int/1000)%10;
		n[2]=(real_int/100)%10;
		n[3]=(real_int/10)%10;
		n[4]=(real_int/1)%10; 
		n[5]='.';
		n[6]=(real_decimal/1000)%10;
		n[7]=(real_decimal/100)%10;
		n[8]=(real_decimal/10)%10;
		n[9]=real_decimal%10;
		n[6+N]='\0'; 
		for(j=0;j<10;j++) n[j]=n[j]+16+32;
		if(real<0) 
		{		 
		  i_Count+=1;
		  n[5-i_Count]='-';
		}
		n[5]='.';
		n[6+N]='\0';   
		OLED_P6x8Str(X,Y,&n[5-i_Count]); 
}

void Dis_Float2(u8 Y,u8 X,double real,u8 N1,u8 N2) 
{
		u8   i_Count=1;
		u8   n[12]={0};
		long   j=1;  
		u16   real_int=0;
		double decimal=0;
		u16   real_decimal=0;
		X=X*8;
		real_int=(int)real;
		//Dis_Num(2,0,real_int,5);
		decimal=real-real_int;
		real_decimal=decimal*1e4;
		//Dis_Num(2,6,real_decimal,4);
		while(real_int/10/j!=0)
		{
			j=j*10;i_Count++;  
		} 
		n[0]=(real_int/10000)%10; 
		n[1]=(real_int/1000)%10;
		n[2]=(real_int/100)%10;
		n[3]=(real_int/10)%10;

		n[5]='.';
		n[6]=(real_decimal/1000)%10;
		n[7]=(real_decimal/100)%10;
		n[8]=(real_decimal/10)%10;
		n[9]=real_decimal%10;
		n[6+N2]='\0'; 
		for(j=0;j<10;j++) n[j]=n[j]+16+32;
		n[5]='.';
		n[6+N2]='\0';   
		OLED_P8x16Str(X,Y,&n[5-N1]); 
}

void Draw_Logo(void)
{ 	
		u16 ii=0;
		u8 x,y;       

		for(y=0;y<8;y++)
		{
			OLED_Set_Pos(0,y);				
			for(x=0;x<128;x++)
				{      
					OLED_WrDat(LOGO128x64[ii++]);	    	
				}
		}
} 

void OLED_P8x16Num_8bit(u8 x,u8 y,u8 Number)
{
		u8 ch[3]={0};
		int n;
		for(n=2;n>=0;n--)
		{
			ch[n]=Number%10+'0';
			Number=Number/10;
		}
		OLED_P8x16Str(x,y,ch);
}

void OLED_P6x8Num_8bit(u8 x,u8 y,u8 Number)
{
		u8 ch[3]={0};
		int n;
		for(n=2;n>=0;n--)
		{
			ch[n]=Number%10+'0';
			Number=Number/10;
		}
		OLED_P6x8Str(x,y,ch);
}

void OLED_2num(u8 x,u8 y,u8 number)
{  
		u8 ge,shi;
		ge = number % 10;
		shi = number / 10;
		OLED_Num(x+1,y,ge);
		OLED_Num(x,y,shi);
}

void OLED_3num(u8 x,u8 y,u16 number)
{ 	
		u8 ge,shi,bai;
		bai = number / 100;
		shi = number % 100 /10;
		ge  = number % 10;
	
		OLED_Num(x,y,bai);
		OLED_Num(x+1,y,shi); 
		OLED_Num(x+2,y,ge);
}

void OLED_4num(u8 x,u8 y, int number)
{ 		
	u8 qian,bai,shi,ge;
	int num =number;
	
	if(num<0)
	{
		 num=-num;
	}
	qian=num/1000;
	bai=num%1000/100;
	shi=num%100/10;
	ge=num%10;

	OLED_Num(x,y,qian);
	OLED_Num(x+1,y,bai);
	OLED_Num(x+2,y,shi);
	OLED_Num(x+3,y,ge);	
}

void OLED_Num(u8 x,u8 y,u8 asc) 
{
    int i=0;
    OLED_Set_Pos(x*6,y);
    for(i=0;i<6;i++)
    {
       OLED_WrDat(F6x8[asc+16][i]);         
    }
}

void OLED_Num5(u8 x,u8 y,u16 number)
{
		u8 wan,qian,bai,shi,ge;
		wan=number/10000;
		qian = number%10000/1000;
		bai=number%1000/100;
		shi=number%100/10;
		ge=number%10;

		OLED_Num(x,y,wan);
		OLED_Num(x+1,y,qian);
		OLED_Num(x+2,y,bai);
		OLED_Num(x+3,y,shi);
		OLED_Num(x+4,y,ge);
}
